mossworks/MW-003-Signal-Generator/README.md

# MW-003-Signal-Generator
Takes 6-36VDC input and generates a selectable 0-10VDC or 0-20mA output (the actual range can be adjusted using the trim pot on the - input of the op-amp).
