mossworks/MW-003-Signal-Generator/eagle/SigGen.brd

## EAGLE design eagle/SigGen.brd (2018-03-12)

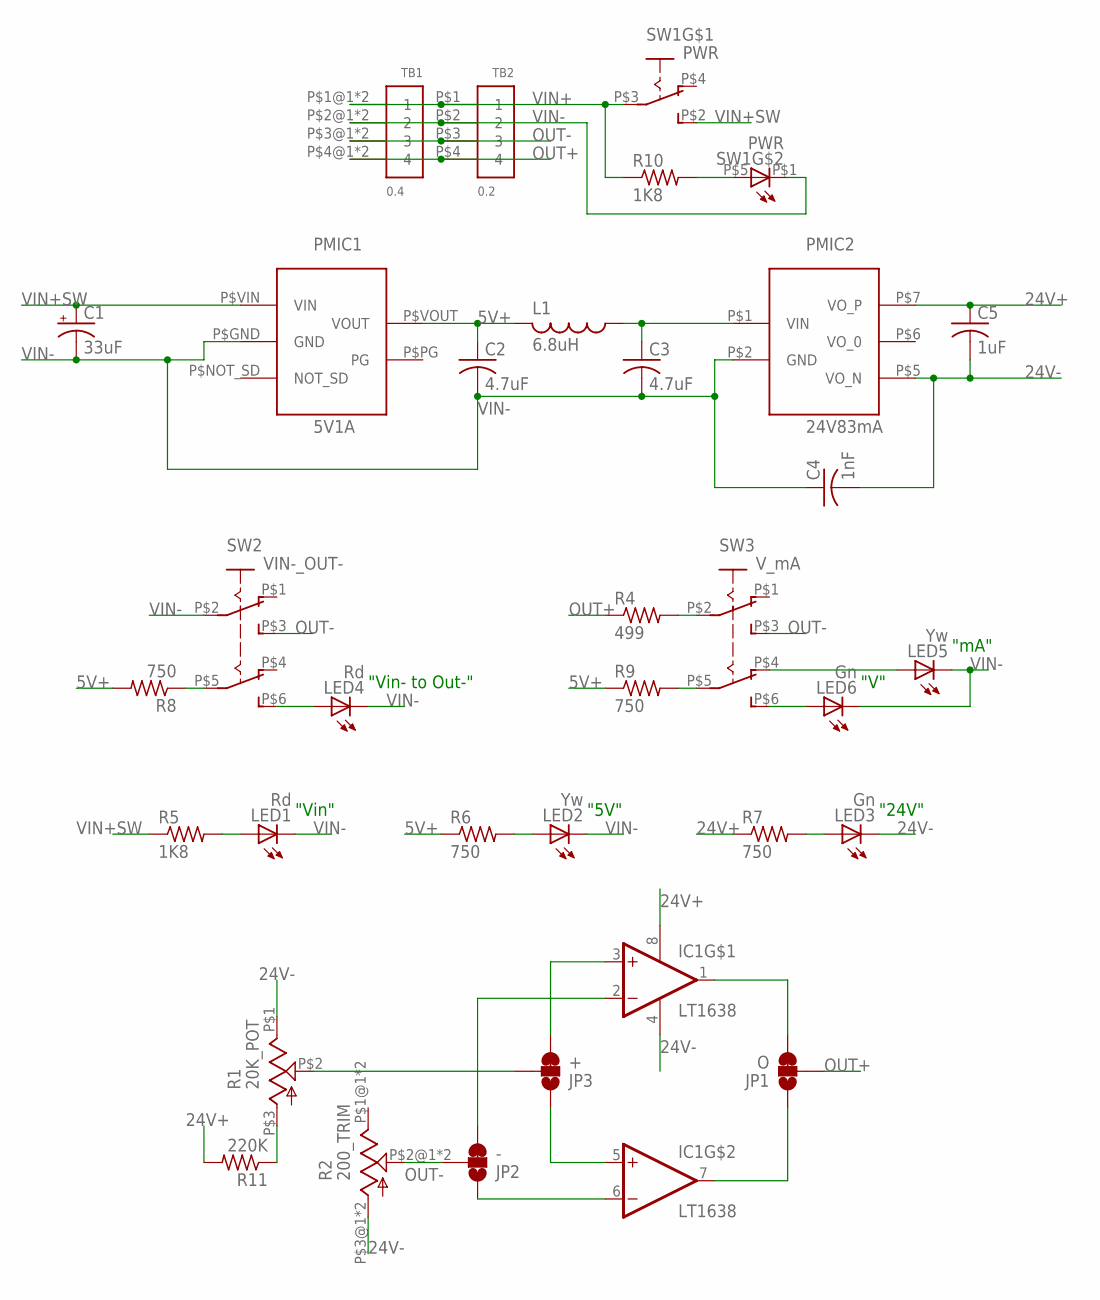
[picture p1: schematic SigGen.sch]

Parts:
C1: 33uF; CAP_0.315D
C2, C3: 4.7uF; C025-024X044
C4: 1nF; C075-032X103
C5: 1uF; C050-024X044
IC1: LT1638; DIP8
JP1: O; SMT-JUMPER_3_1-NC_TRACE_NO-SILK
JP2: -; SMT-JUMPER_3_1-NC_TRACE_NO-SILK
JP3: +; SMT-JUMPER_3_1-NC_TRACE_NO-SILK
L1: 6.8uH; IND_0.197D
LED1, LED4: Rd; LED3MM
LED2, LED5: Yw; LED3MM
LED3, LED6: Gn; LED3MM
PMIC1: 5V1A; PMIC_POLOLU-5X7
PMIC2: 24V83mA; PMIC_PEM2-S
R1: 20K_POT; POT_PDB181-K
R2: 200_TRIM; POT_89
R4: 499; 0204/7
R5, R10: 1K8; 0204/7
R6, R7, R8, R9: 750; 0204/7
R11: 220K; 0204/7
SW1: PWR; ELUM_SWITCH_TH_ILLUMINATED
SW2: VIN-_OUT-; SW_TL2201
SW3: V_mA; SW_TL2201
TB1: 0.4; 1X04_LARGE_10.16MM
TB2: 0.2; 1X04_LARGE_5.08MM

Connections:
5V+: C2.1, L1.P$2 (2), PMIC1.P$VOUT (VOUT), R6.1, R8.2, R9.1
24V+: C5.1, IC1.8 (V+), PMIC2.P$7 (VO_P), R7.1, R11.2
24V-: C4.2, C5.2, IC1.4 (V-), LED3.K (C), PMIC2.P$5 (VO_N), R1.P$1 (CCW), R2.P$3@1 (CW), R2.P$3@2 (CW)
unnamed: LED1.A, R5.2
unnamed: C3.1, L1.P$1 (1), PMIC2.P$1 (VIN)
unnamed: R8.1, SW2.P$5 (COM2)
unnamed: LED2.A, R6.2
unnamed: LED3.A, R7.2
unnamed: R4.2, SW3.P$2 (COM1)
unnamed: LED4.A, SW2.P$6 (NO2)
unnamed: R9.2, SW3.P$5 (COM2)
unnamed: LED6.A, SW3.P$6 (NO2)
unnamed: LED5.A, SW3.P$4 (NC2)
unnamed: R1.P$3 (CW), R11.1
unnamed: JP3.2, R1.P$2 (WIPER)
unnamed: IC1.7 (OUT), JP1.1
unnamed: R10.2, SW1.P$5 (A)
unnamed: IC1.1 (OUT), JP1.3
unnamed: IC1.3 (+IN), JP3.3
unnamed: IC1.5 (+IN), JP3.1
unnamed: IC1.2 (-IN), JP2.3
unnamed: IC1.6 (-IN), JP2.1
OUT+: JP1.2, R4.1, TB1.P$4@1 (4), TB1.P$4@2 (4), TB2.P$4 (4)
OUT-: JP2.2, R2.P$2@1 (WIPER), R2.P$2@2 (WIPER), SW2.P$3 (NO1), SW3.P$3 (NO1), TB1.P$3@1 (3), TB1.P$3@2 (3), TB2.P$3 (3)
VIN+: R10.1, SW1.P$3 (COM), TB1.P$1@1 (1), TB1.P$1@2 (1), TB2.P$1 (1)
VIN+SW: C1.P$2_POS (+), PMIC1.P$VIN (VIN), R5.1, SW1.P$2 (NO)
VIN-: C1.P$1_NEG (-), C2.2, C3.2, C4.1, LED1.K (C), LED2.K (C), LED4.K (C), LED5.K (C), LED6.K (C), PMIC1.P$GND (GND), PMIC2.P$2 (GND), SW1.P$1 (C), SW2.P$2 (COM1), TB1.P$2@1 (2), TB1.P$2@2 (2), TB2.P$2 (2)

Notes on the sheet:
"Vin"
"5V"
"24V"
"Vin- to Out-"
"V"
"mA"

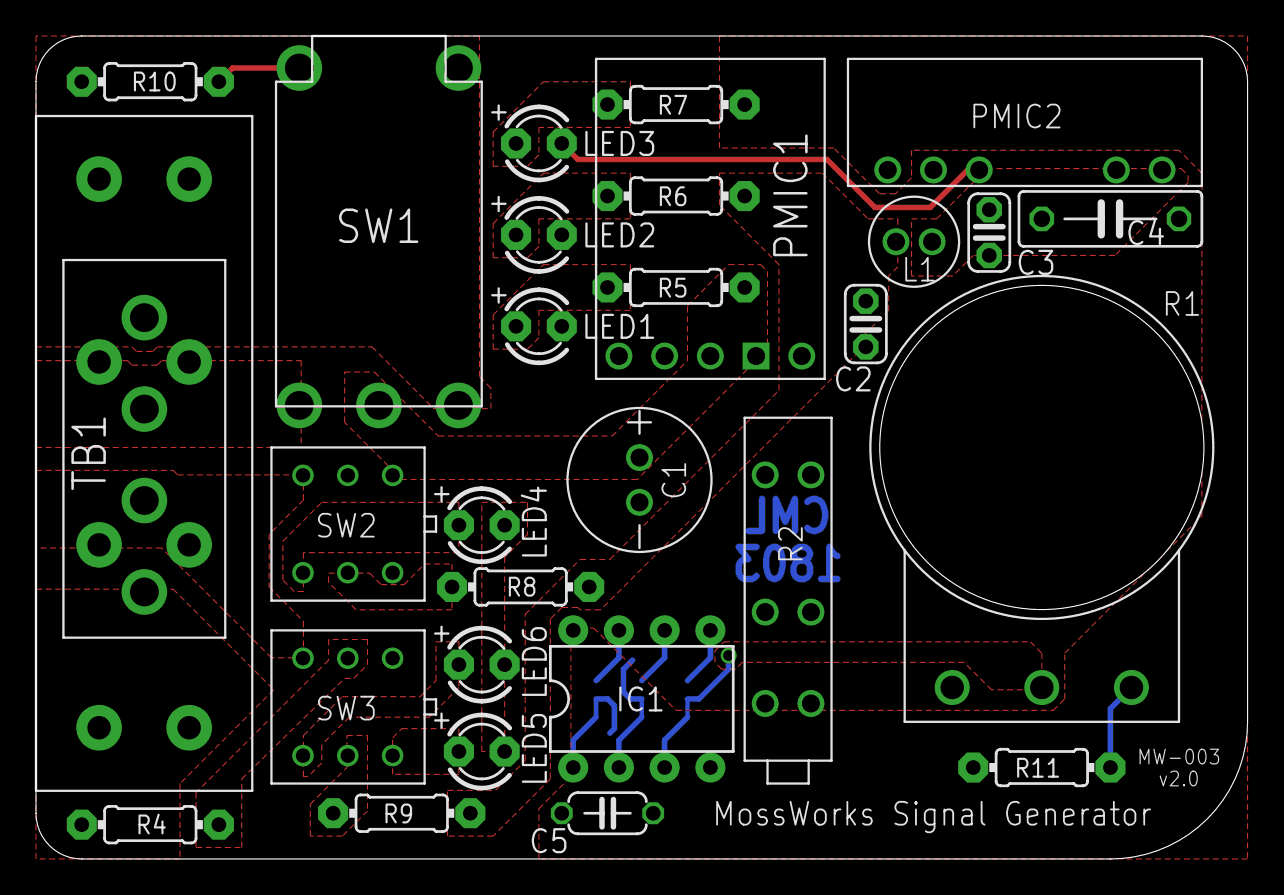
[picture p2: board SigGen.brd from above]

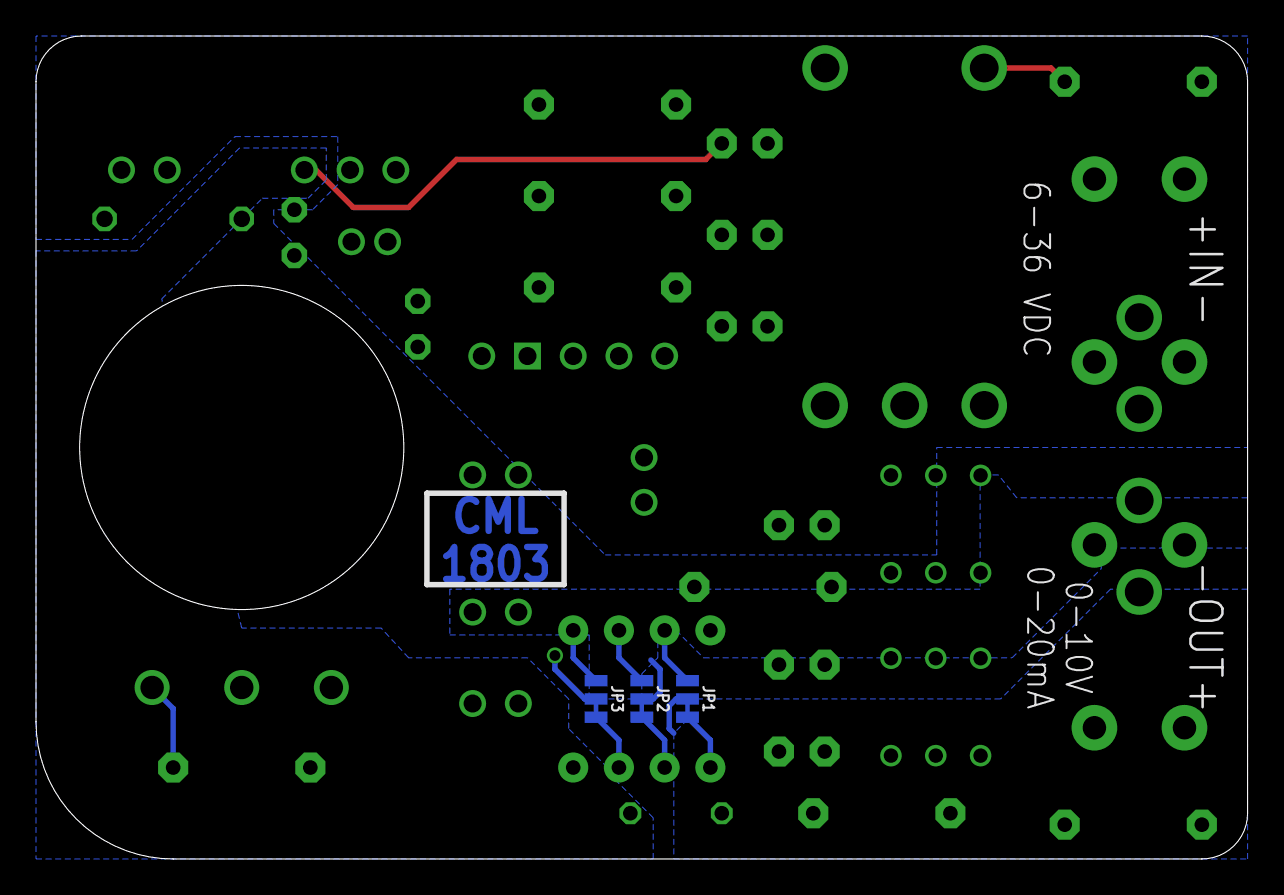
[picture p3: board SigGen.brd from below]

Board: 2 copper layers, 67.3 x 45.7 mm, 33 parts (3 on the bottom side), 27 nets.
